dabgxd/micromouse/tools/planner/out/recovery_table.md

# Bảng chỉnh xe

Đặt **đuôi xe sát sau vạch k** (vạch cuối cùng mà cả xe đã qua), thân xe **song song làn**,
tâm xe cách mốc một khoảng như bảng, rồi bấm KEY.

| Vạch k | Ô | Tâm xe cách mốc | Mốc đo | Box được tính khi qua vạch này |
|---|---|---|---|---|
| 1 | 1 | **20.4 cm** | đo từ biên TRÁI (x=0) sang phải | - |
| 2 | 1 | **17.4 cm** | đo từ biên TRÁI (x=0) sang phải | #1 |
| 3 | 1 | **15.3 cm** | đo từ biên TRÁI (x=0) sang phải | #2 |
| 4 | 1 | **17.4 cm** | đo từ biên TRÁI (x=0) sang phải | #3 |
| 5 | 1 | **22.2 cm** | đo từ biên TRÁI (x=0) sang phải | #4 |
| 6 | 1 | **31.1 cm** | đo từ biên TRÁI (x=0) sang phải | #5 |
| 7 | 2 | **20.3 cm** | đo dọc vạch chéo, từ góc trong chữ U ra ngoài | #6 |
| 8 | 2 | **26.3 cm** | đo dọc vạch chéo, từ góc trong chữ U ra ngoài | #7 |
| 9 | 2 | **29.8 cm** | đo dọc vạch chéo, từ góc trong chữ U ra ngoài | #8 |
| 10 | 3 | **32.4 cm** | đo từ biên TRÊN (y=1200) xuống dưới | #9 |
| 11 | 3 | **34.8 cm** | đo từ biên TRÊN (y=1200) xuống dưới | #10 |
| 12 | 3 | **37.2 cm** | đo từ biên TRÊN (y=1200) xuống dưới | #11 |
| 13 | 3 | **40.0 cm** | đo từ biên TRÊN (y=1200) xuống dưới | #12 |
| 14 | 3 | **49.6 cm** | đo từ biên TRÊN (y=1200) xuống dưới | - |
| 15 | 3 | **51.5 cm** | đo từ biên TRÊN (y=1200) xuống dưới | #13 |
| 16 | 4 | **8.6 cm** | đo dọc vạch chéo, từ góc trong chữ U ra ngoài | #14 |
| 17 | 4 | **18.6 cm** | đo dọc vạch chéo, từ góc trong chữ U ra ngoài | - |
| 18 | 4 | **9.3 cm** | đo dọc vạch chéo, từ góc trong chữ U ra ngoài | - |
| 19 | 5 | **50.0 cm** | đo từ biên PHẢI (x=1800) sang trái | - |
| 20 | 5 | **50.7 cm** | đo từ biên PHẢI (x=1800) sang trái | #15 |
| 21 | 5 | **51.4 cm** | đo từ biên PHẢI (x=1800) sang trái | - |
| 22 | 5 | **51.2 cm** | đo từ biên PHẢI (x=1800) sang trái | #17 |
| 23 | 5 | **51.6 cm** | đo từ biên PHẢI (x=1800) sang trái | #16 |
| 24 | 5 | **50.7 cm** | đo từ biên PHẢI (x=1800) sang trái | - |
