dabgxd/micromouse/docs/2d_micromouse.pdf

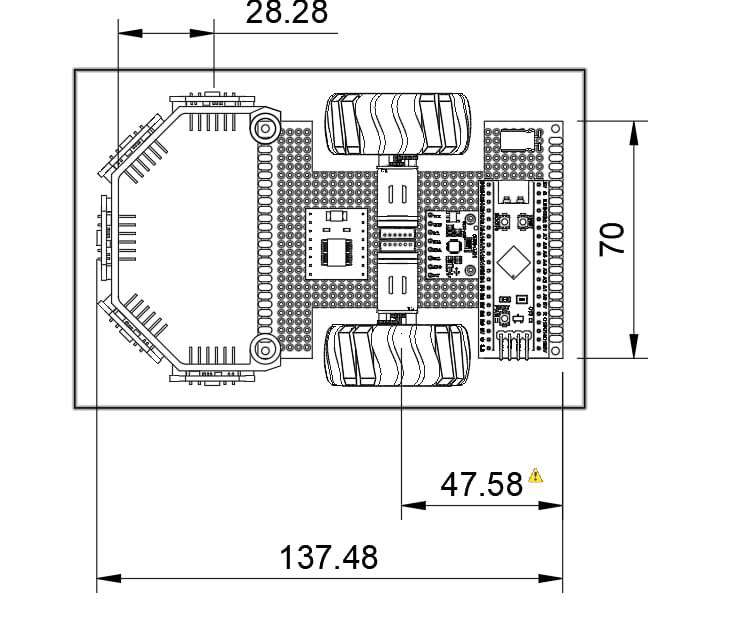
[picture p14: page 1]
