dabgxd/micromouse/docs/map2d.jpg

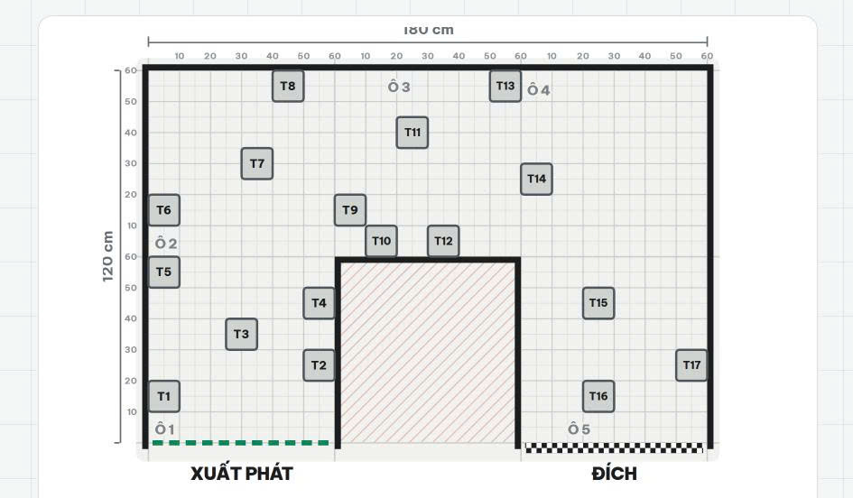
docs/map2d.jpg
