dabgxd/micromouse/schematic/schematic_micromouse.png

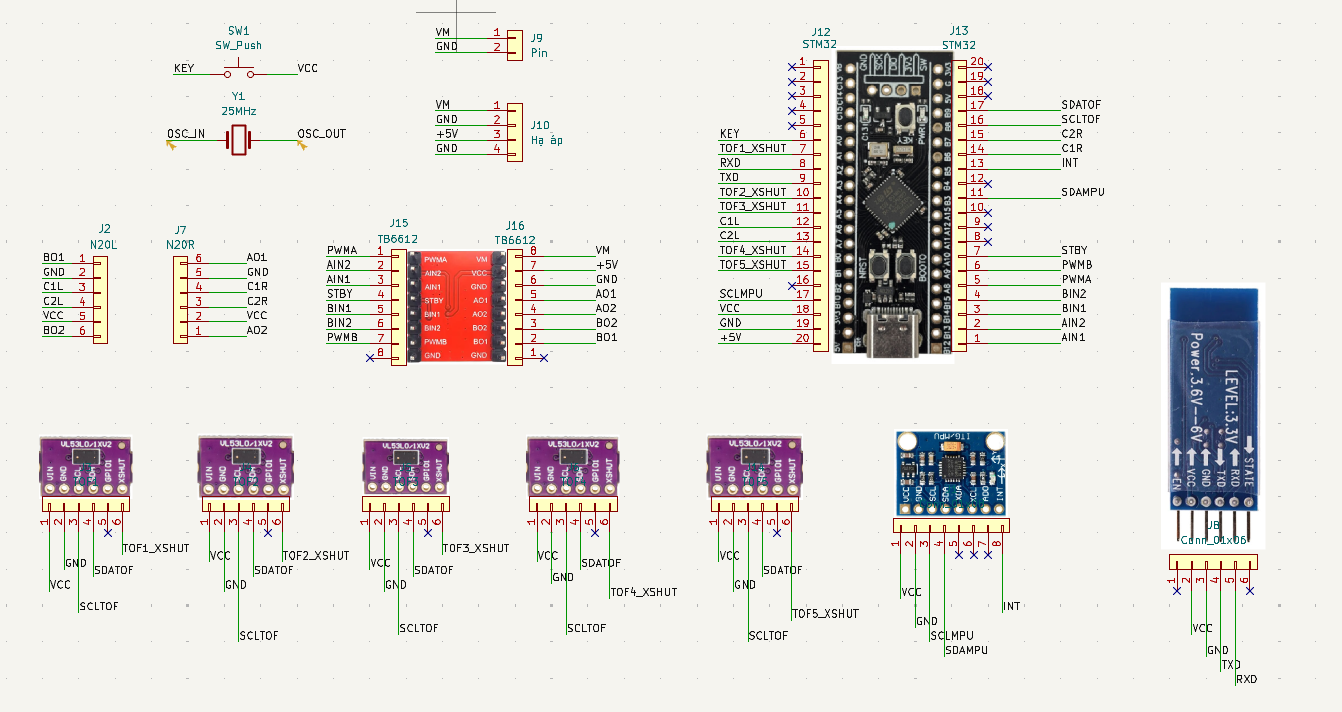
schematic/schematic_micromouse.png
