dabgxd/micromouse/tools/planner/out/recovery_cards.png

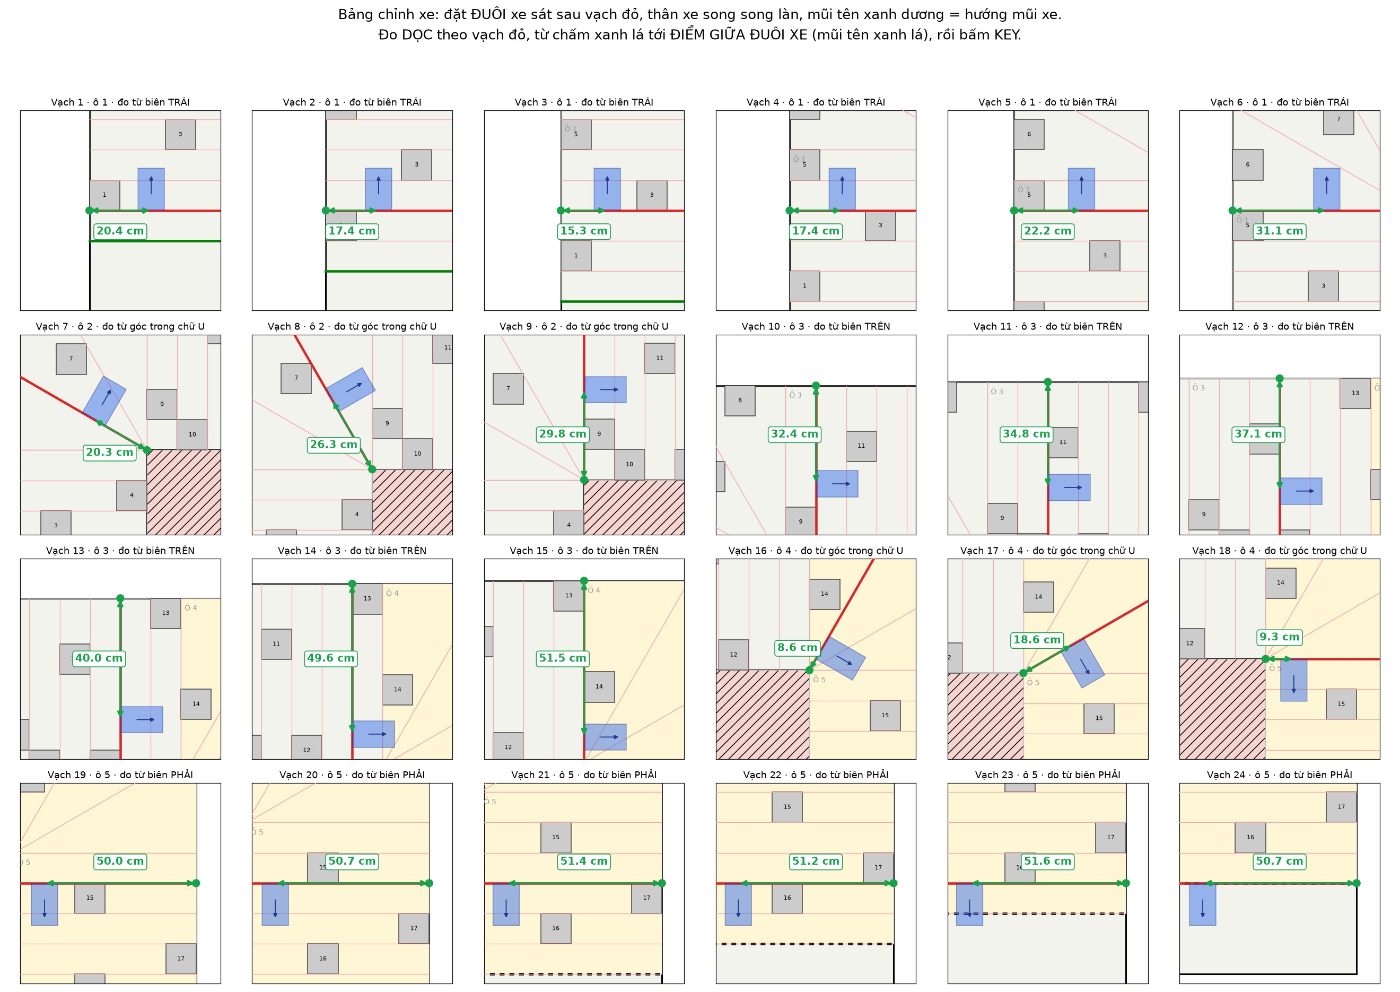
tools/planner/out/recovery_cards.png
