dabgxd/micromouse/tools/planner/out/recovery_overview.png

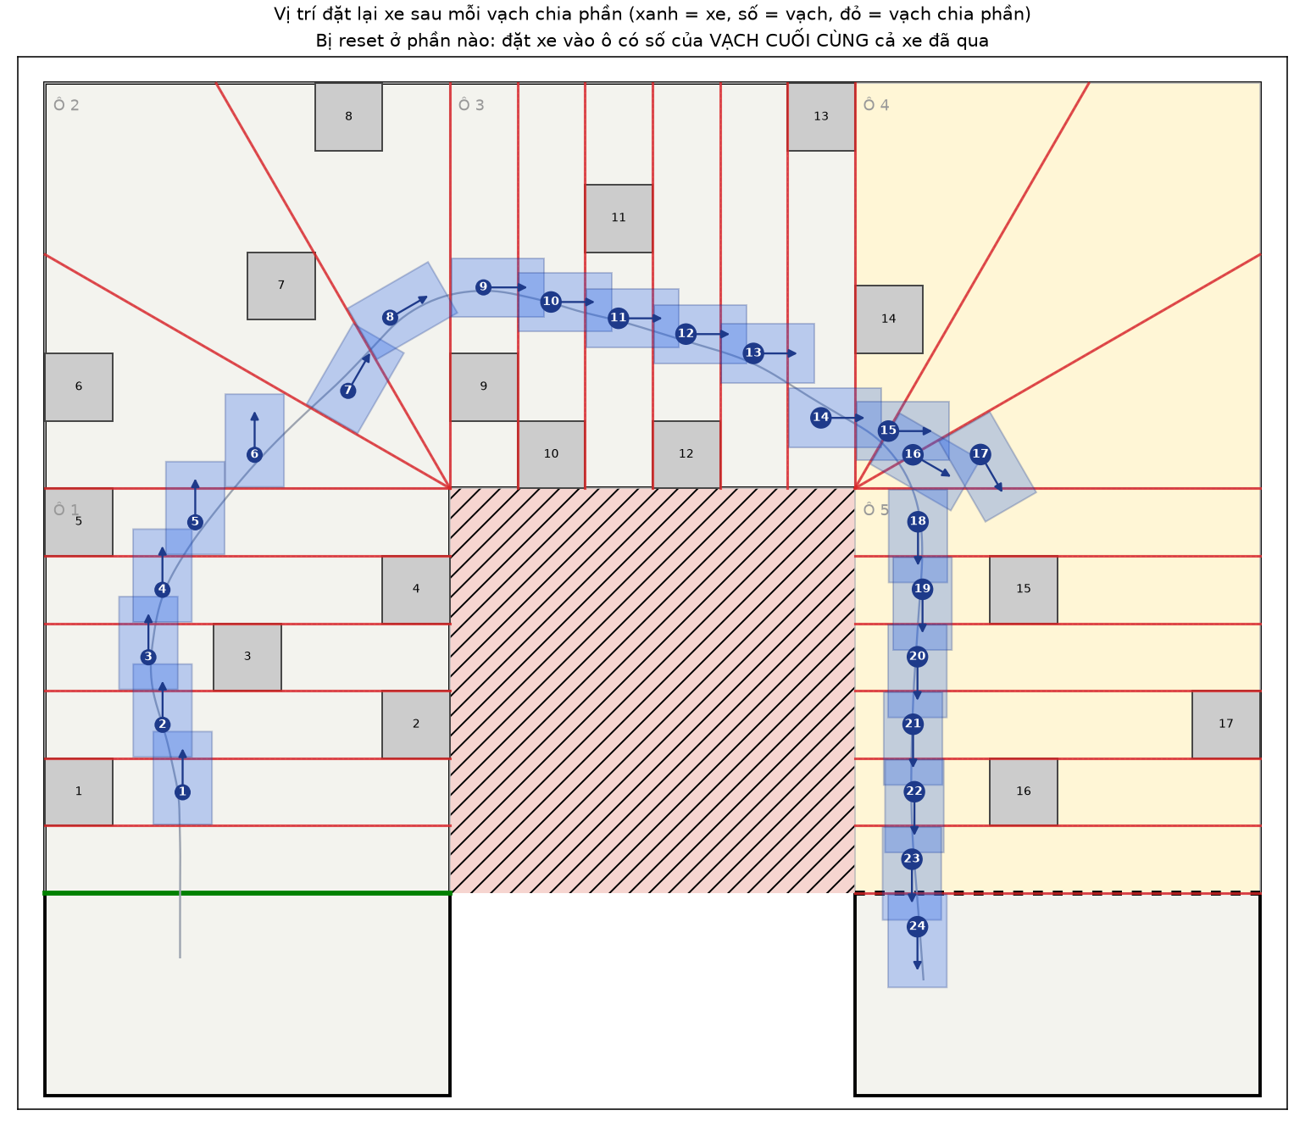
tools/planner/out/recovery_overview.png
