dabgxd/micromouse/tools/planner/out/trajectory.png

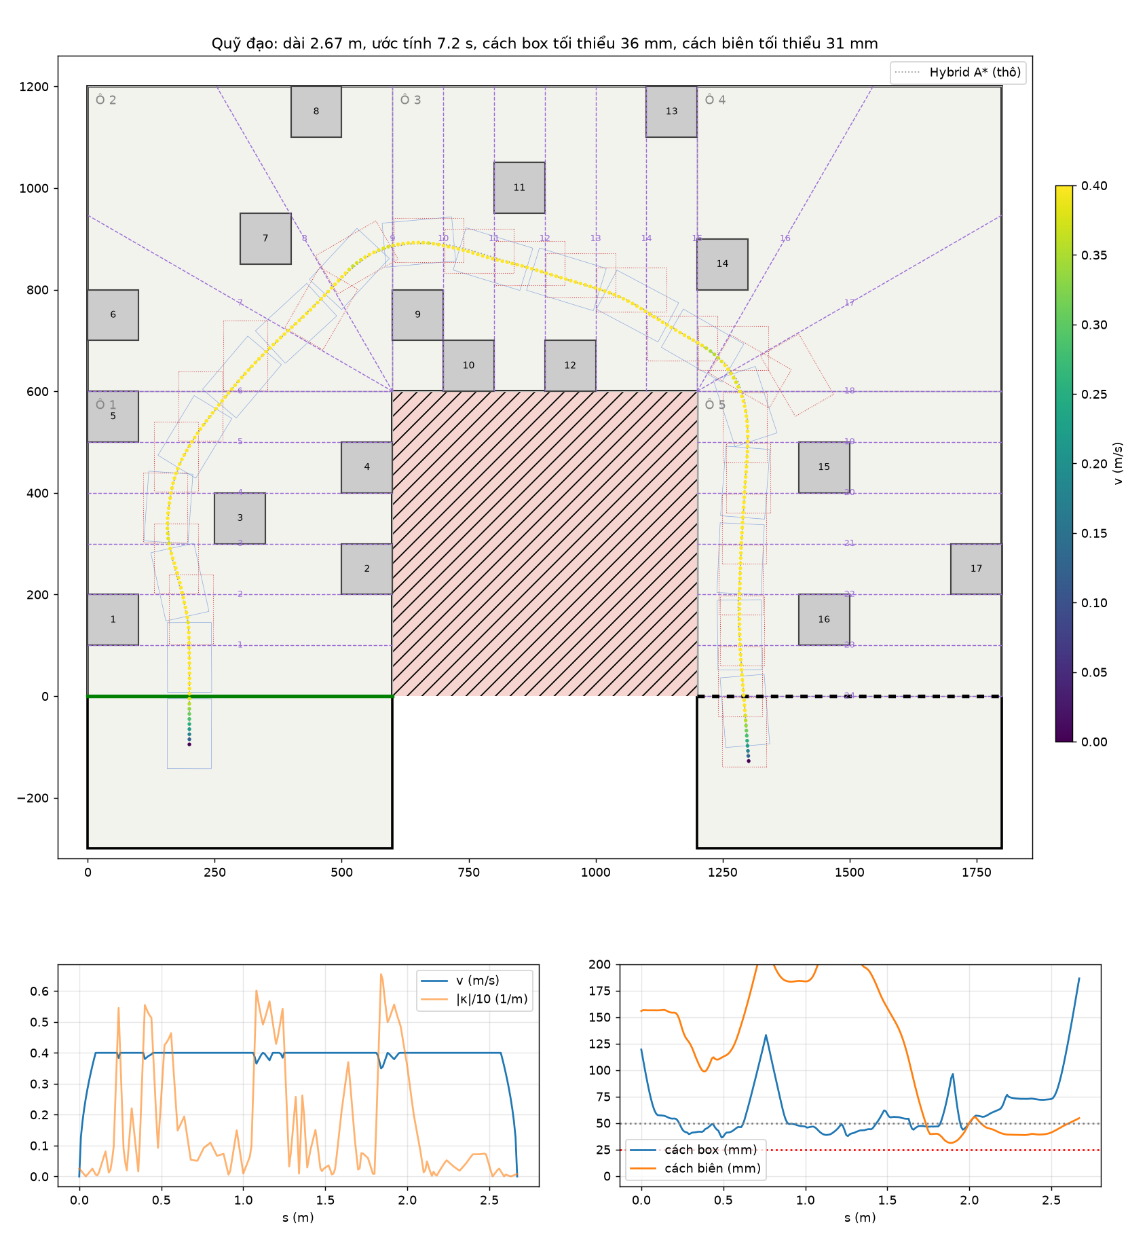
tools/planner/out/trajectory.png
