dabgxd/micromouse/(list of files, cad)

Other CAD files:
cad_files/micromouse_nhung.step
