dabgxd/micromouse/firmware/firmware_micromouse.ioc

Mcu.UserName=STM32F411CEUx
PA0-WKUP.GPIO_Label=KEY
PA0-WKUP.Signal=GPIO_Input
PA1.GPIO_Label=TOF_L90_XSHUT
PA1.Signal=GPIO_Output
PA10.GPIO_Label=STBY_TB6612
PA10.Signal=GPIO_Output
PA13.Signal=SYS_JTMS-SWDIO
PA14.Signal=SYS_JTCK-SWCLK
PA2.GPIO_Label=RXD_HC05
PA2.Signal=USART2_TX
PA3.GPIO_Label=TXD_HC05
PA3.Signal=USART2_RX
PA4.GPIO_Label=TOF_L45_XSHUT
PA4.Signal=GPIO_Output
PA5.GPIO_Label=TOF_M0_XSHUT
PA5.Signal=GPIO_Output
PA6.GPIO_Label=ENCODER_L_B
PA6.Signal=S_TIM3_CH1
PA7.GPIO_Label=ENCODER_L_A
PA7.Signal=S_TIM3_CH2
PA8.GPIO_Label=PWMA_R_TB6612
PA8.Signal=S_TIM1_CH1
PA9.GPIO_Label=PWMB_L_TB6612
PA9.Signal=S_TIM1_CH2
PB0.GPIO_Label=TOF_R45_XSHUT
PB0.Signal=GPIO_Output
PB1.GPIO_Label=TOF_R90_XSHUT
PB1.Signal=GPIO_Output
PB10.GPIO_Label=SCL_MPU6050
PB10.Signal=I2C2_SCL
PB12.GPIO_Label=AIN1_TB6612
PB12.Signal=GPIO_Output
PB13.GPIO_Label=AIN2_TB6612
PB13.Signal=GPIO_Output
PB14.GPIO_Label=BIN1_TB6612
PB14.Signal=GPIO_Output
PB15.GPIO_Label=BIN2_TB6612
PB15.Signal=GPIO_Output
PB3.GPIO_Label=SDA_MPU6050
PB3.Signal=I2C2_SDA
PB5.GPIO_Label=MPU_INT
PB5.Signal=GPXTI5
PB6.GPIO_Label=ENCODER_R_B
PB6.Signal=S_TIM4_CH1
PB7.GPIO_Label=ENCODER_R_A
PB7.Signal=S_TIM4_CH2
PB8.GPIO_Label=SCL_TOF
PB8.Signal=I2C1_SCL
PB9.GPIO_Label=SDA_TOF
PB9.Signal=I2C1_SDA
PC13-ANTI_TAMP.Signal=GPIO_Output
