dabgxd/micromouse/firmware/Inc/main.h

#define KEY_Pin GPIO_PIN_0
#define KEY_GPIO_Port GPIOA
#define TOF_L90_XSHUT_Pin GPIO_PIN_1
#define TOF_L90_XSHUT_GPIO_Port GPIOA
#define RXD_HC05_Pin GPIO_PIN_2
#define RXD_HC05_GPIO_Port GPIOA
#define TXD_HC05_Pin GPIO_PIN_3
#define TXD_HC05_GPIO_Port GPIOA
#define TOF_L45_XSHUT_Pin GPIO_PIN_4
#define TOF_L45_XSHUT_GPIO_Port GPIOA
#define TOF_M0_XSHUT_Pin GPIO_PIN_5
#define TOF_M0_XSHUT_GPIO_Port GPIOA
#define ENCODER_L_B_Pin GPIO_PIN_6
#define ENCODER_L_B_GPIO_Port GPIOA
#define ENCODER_L_A_Pin GPIO_PIN_7
#define ENCODER_L_A_GPIO_Port GPIOA
#define TOF_R45_XSHUT_Pin GPIO_PIN_0
#define TOF_R45_XSHUT_GPIO_Port GPIOB
#define TOF_R90_XSHUT_Pin GPIO_PIN_1
#define TOF_R90_XSHUT_GPIO_Port GPIOB
#define SCL_MPU6050_Pin GPIO_PIN_10
#define SCL_MPU6050_GPIO_Port GPIOB
#define AIN1_TB6612_Pin GPIO_PIN_12
#define AIN1_TB6612_GPIO_Port GPIOB
#define AIN2_TB6612_Pin GPIO_PIN_13
#define AIN2_TB6612_GPIO_Port GPIOB
#define BIN1_TB6612_Pin GPIO_PIN_14
#define BIN1_TB6612_GPIO_Port GPIOB
#define BIN2_TB6612_Pin GPIO_PIN_15
#define BIN2_TB6612_GPIO_Port GPIOB
#define PWMA_R_TB6612_Pin GPIO_PIN_8
#define PWMA_R_TB6612_GPIO_Port GPIOA
#define PWMB_L_TB6612_Pin GPIO_PIN_9
#define PWMB_L_TB6612_GPIO_Port GPIOA
#define STBY_TB6612_Pin GPIO_PIN_10
#define STBY_TB6612_GPIO_Port GPIOA
#define SDA_MPU6050_Pin GPIO_PIN_3
#define SDA_MPU6050_GPIO_Port GPIOB
#define MPU_INT_Pin GPIO_PIN_5
#define MPU_INT_GPIO_Port GPIOB
#define MPU_INT_EXTI_IRQn EXTI9_5_IRQn
#define ENCODER_R_B_Pin GPIO_PIN_6
#define ENCODER_R_B_GPIO_Port GPIOB
#define ENCODER_R_A_Pin GPIO_PIN_7
#define ENCODER_R_A_GPIO_Port GPIOB
#define SCL_TOF_Pin GPIO_PIN_8
#define SCL_TOF_GPIO_Port GPIOB
#define SDA_TOF_Pin GPIO_PIN_9
#define SDA_TOF_GPIO_Port GPIOB
