dabgxd/micromouse/(commit log)

2026-11-04 fix: change firmware and web from bluetooth classic to ble
    [commands.c, firmware_micromouse.ioc, hwtest.c, hwtest.h, hwtest_internal.h]
2026-11-04 Add CAD file
    [micromouse_nhung.step]
2026-11-04 Add Micromouse schematic image
